codr-void/parking-counter/parking_counter/B_Layer.png

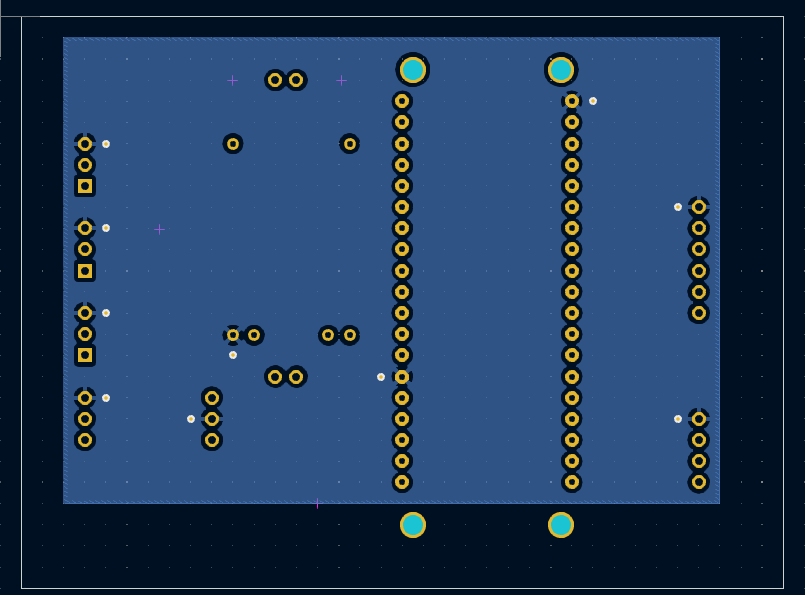
parking_counter/B_Layer.png
