codr-void/parking-counter/parking_counter/F_Layer.png

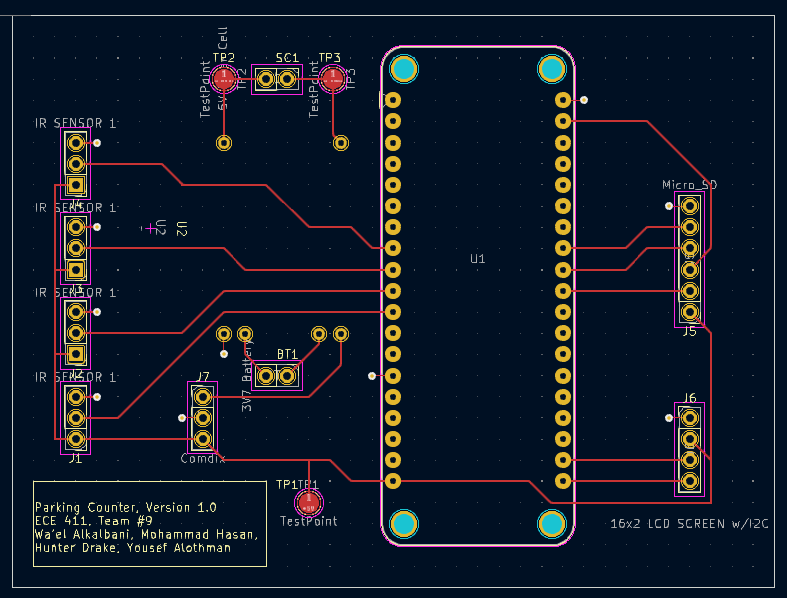
parking_counter/F_Layer.png
