codr-void/parking-counter/Team09_Bill_of_Materials.xlsx

Bill Of Materials for: Team09 - Wa'el Alkalbani, Mohammad Hasan, Hunter Drake, Yousef Alothman
Last modified: November 8th, 2023
PCB version: 1.0
BOM revision: 1.0 |  | P/NP | = Place/Not Place (components marked NP are not stuffed on the board)
Cnt | Part References | P/NP | Mfg | Mfg PN | Description | Dist | Dist Part Number | Cost Ea. | Cost Total
4 | J4,J3,J2,J1 | NP | HiLetGo | 3-01-1963 | IR SENSOR | amazon | 3-01-1963 | $0.88 | $3.52
1 | U2 | P | NanJing Top Power ASIC Corp | ‎TP4056 | BATTERY CHARGER | amazon | 0‎3-01-0205 | $0.78 | $0.78
1 | J7 | P | MicrOne | ME2108 | Step up voltage regualtor to control battery voltage to get 5v | amazon | CP323 | $0.80 | $0.80
1 | SC1 | NP | NA | NA | 5-6V solar panel | EPL | NA | $0.60 | $0.60
1 | J6 | NP | SunFounder | CN0295D | lcd screen with I2C interface | EPL | NA | $0.00 | $0.00
1 | U1 | P | HiLetGo | 211-181007 | esp32s microcontroller - with Wifi module | amazon | 03-01-1287 | $0.00 | $0.00
1 | J5 | P | ANMBEST | ‎ANMBEST_MD272 | SD card reader | amazon | ‎ANMBEST_MD272 | $1.80 | $1.80
1 | NA | P | NA | NA | SD card | EPL | NA | NA | NA | NOT ordered yet
1 | NA | NP | EPL | NA | 3D print of parking lot for the simulation | EPL | NA | NA | NA | NOT ordered yet
1 | NA | NP | EPL | NA | PCB | EPL | NA | NA | NA | NOT ordered yet
1 | BT1 | NP | AOLIKES | 2S1PMJ1 | 7.4V battery - 2600 mAh Lithium Ion | amazon | 2S1P Akku | $15.82 | $15.82
VERSION INFO
Rev | Date | Notes
1 | 2023-11-09 | Rough draft for the bill of materials - included items that we will need and it will be an expense for the next revision
