codr-void/parking-counter/full_parking_counter_bambu.3mf

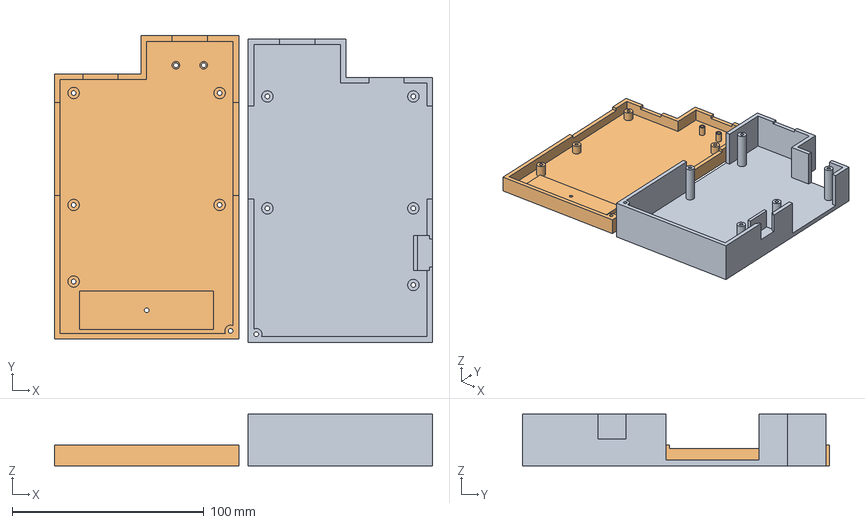
[picture p6: CAD file, 2023-12-07]
full_parking_counter_bambu.3mf
197.3 x 160.2 x 27.0 mm
Top
Bottom
