codr-void/parking-counter/parking_sim.3mf

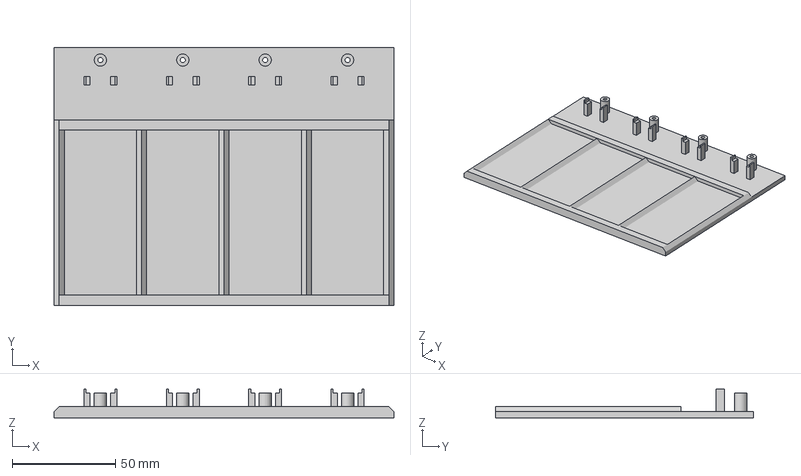
[picture p7: CAD file, 2023-12-07]
parking_sim.3mf
165.0 x 125.0 x 14.0 mm
