codr-void/parking-counter/solar_panel_housing.3mf

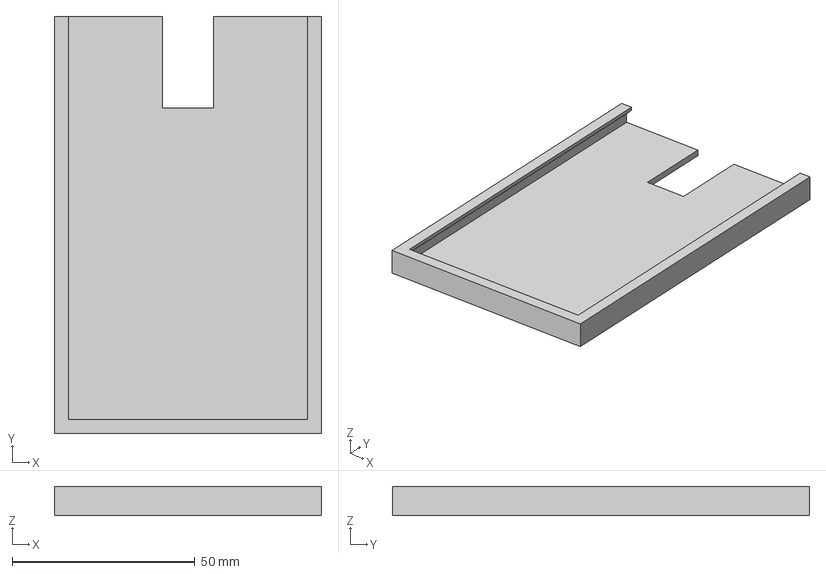
[picture p8: CAD file, 2023-12-07]
solar_panel_housing.3mf
73.0 x 114.0 x 8.00 mm
