codr-void/parking-counter/solar_panel_leg.3mf

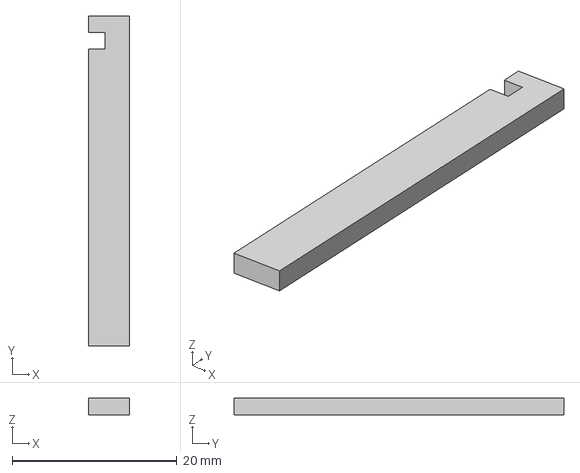
[picture p9: CAD file, 2023-12-07]
solar_panel_leg.3mf
5.00 x 40.0 x 2.00 mm
