codr-void/parking-counter/16x2_back.stl

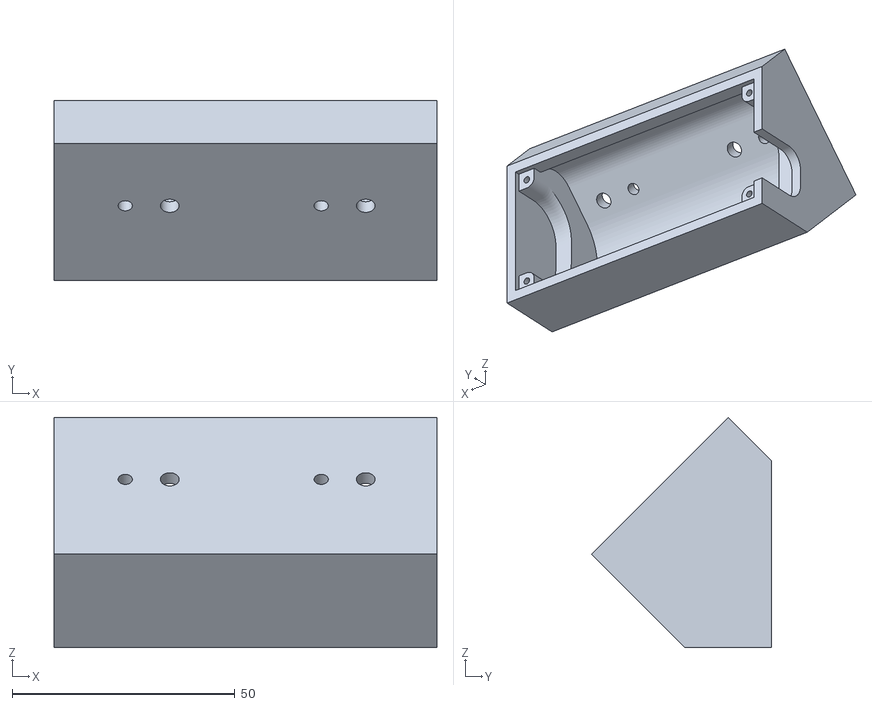
[picture p10: CAD file, 2023-12-07]
16x2_back.stl
86.0 x 40.4 x 51.7
