codr-void/parking-counter/16x2_front.stl

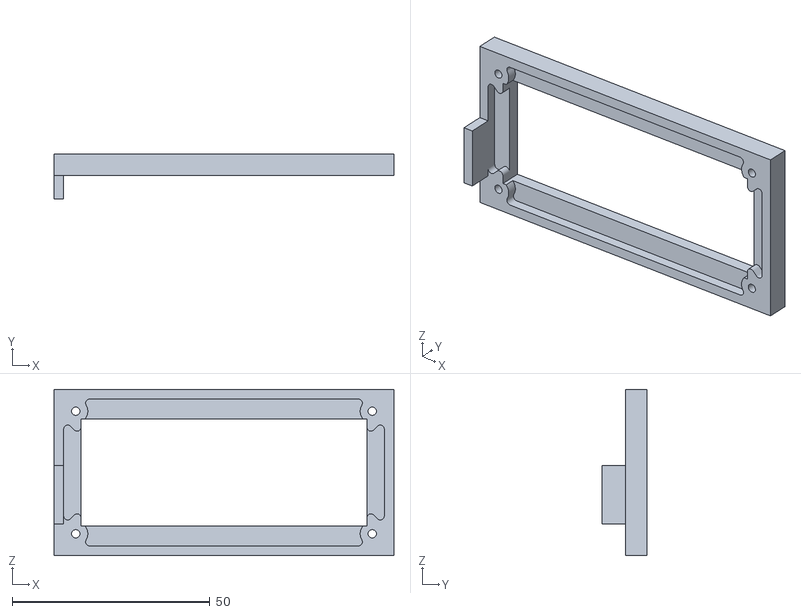
[picture p11: CAD file, 2023-12-07]
16x2_front.stl
86.0 x 11.5 x 42.0
