codr-void/parking-counter/parking_counter_preliminary_schematic.pdf

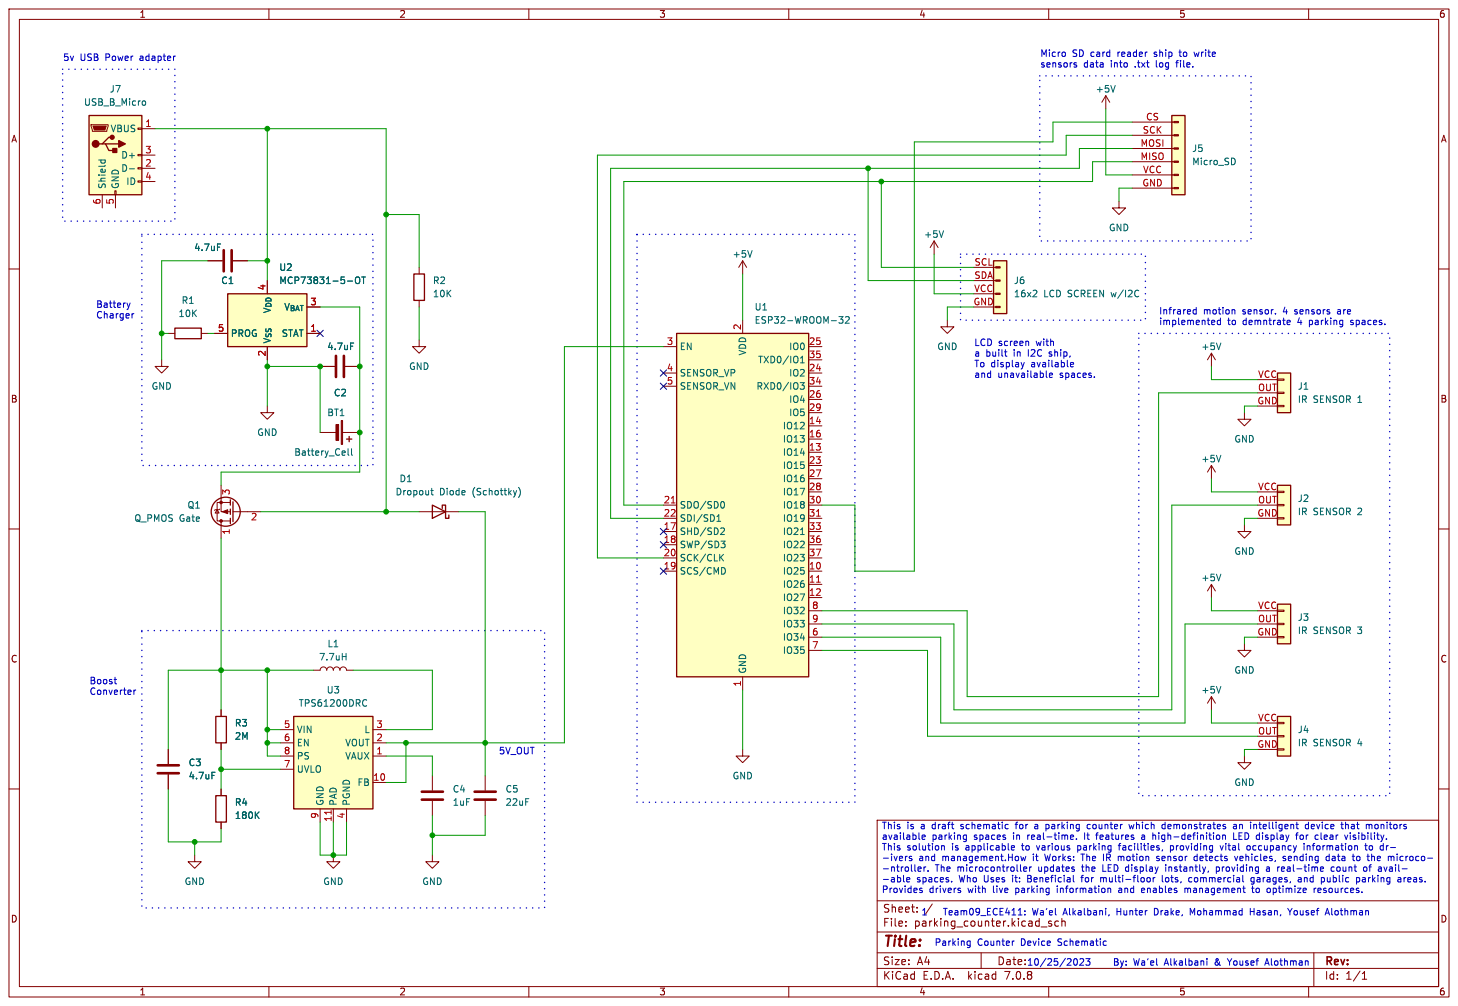
[picture p12: page 1]

Micro SD card reader ship to write

sensors data into .txt log file. 5v USB Power adapter

CS GND MISO MOSI SCK

VCC
IR SENSOR 2 GND GND

2 SCK/CLK 20 SDO/SD0 21 SDI/SD1 22

a built in I2C ship, To display available

3 Q1 Q_PMOS Gate D1 Dropout Diode (Schottky) L1

4 VIN 5 EN 6 UVLO 7 PS 8 GND

Id: 1/1 Title: File: parking_counter.kicad_sch Sheet: /
