codr-void/parking-counter/ECE 411 Functional Diagram Team #9.pdf

## Parking Counter Device: L1 Diagram

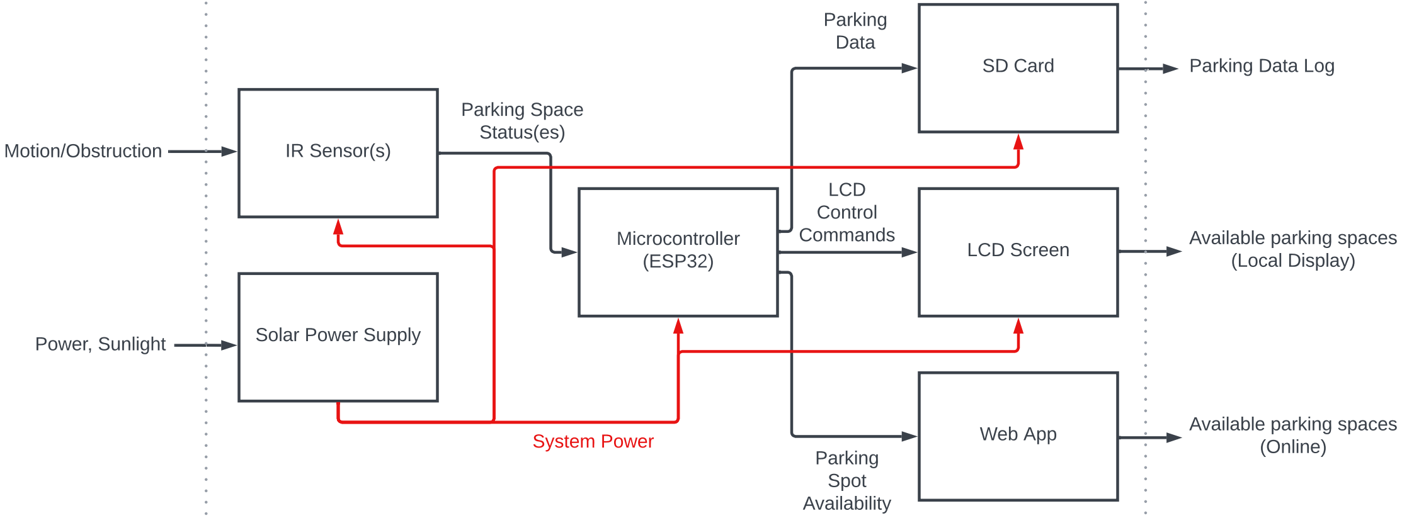
[picture p13: figure]
Microcontroller (ESP32); Solar Power Supply; IR Sensor(s); SD Card; LCD Screen; Web App; Power, Sunlight; Available parking spaces (Local Display); Parking Data Log; Available parking spaces (Online); Motion/Obstruction; System Power; Parking Space Status(es); Parking Data; LCD Control Commands; Parking Spot Availability
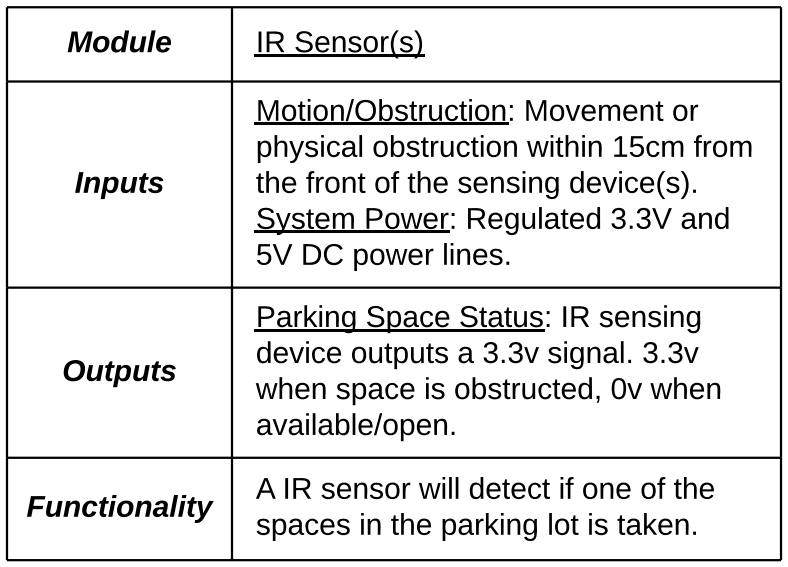
[picture p14: figure]
Module; IR Sensor(s); Inputs; Motion/Obstruction: Movement or physical obstruction within 15cm from the front of the sensing device(s). System Power: Regulated 3.3V and 5V DC power lines.; Outputs; Parking Space Status: IR sensing device outputs a 3.3v signal. 3.3v when space is obstructed, 0v when available/open.

Functionality | A IR sensor will detect if one of the spaces in the parking lot is taken.

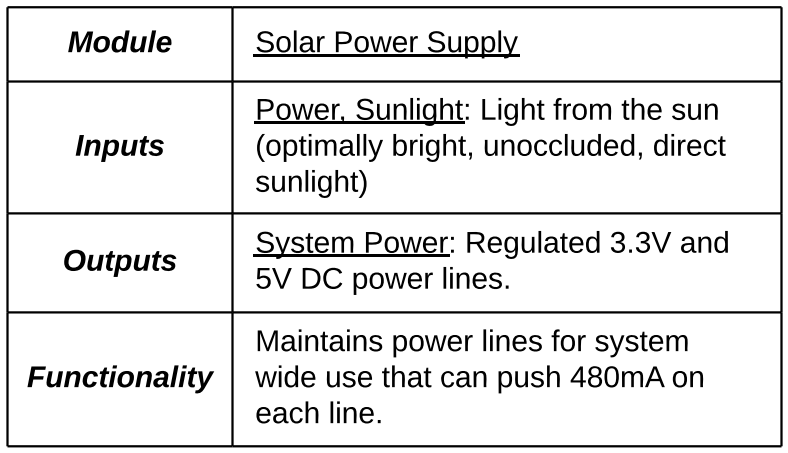
[picture p15: figure]
Module; Solar Power Supply; Inputs; Power, Sunlight: Light from the sun (optimally bright, unoccluded, direct sunlight); Outputs; System Power: Regulated 3.3V and; 5V DC power lines.

Functionality | Maintains power lines for system wide use that can push 480mA on each line.

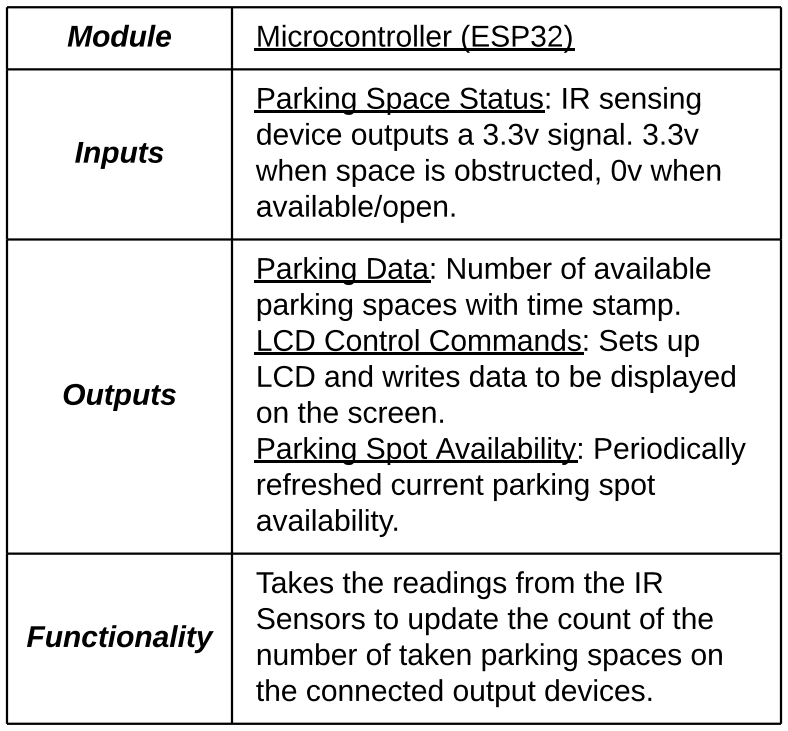
[picture p16: figure]
Module; Microcontroller (ESP32); Inputs; Parking Space Status: IR sensing device outputs a 3.3v signal. 3.3v when space is obstructed, 0v when available/open.; Outputs; Parking Data: Number of available parking spaces with time stamp. LCD Control Commands: Sets up LCD and writes data to be displayed on the screen. Parking Spot Availability: Periodically refreshed current parking spot availability.

Functionality | Takes the readings from the IR Sensors to update the count of the number of taken parking spaces on the connected output devices.
Module | SD Card
Inputs | Parking Data: Number of available parking spaces with time stamp.
Outputs | Parking Data Log: List of times with their corresponding measured number of parking spaces available.
Functionality | Logs parking data and time stamps.
Module | LCD Screen
Inputs | LCD Control Commands: Sets up LCD and writes data to be displayed on the screen.
Outputs | Available parking spaces (Local Display): The number of parking spaces not yet sensed as being taken displayed on hardware.
Functionality | Displays the number of parking spaces available on-site
Module | Web App
Inputs | Parking Spot Availability: Periodically refreshed current parking spot availability.
Outputs | Available parking spaces (Online): The number of parking spaces not yet sensed as being taken displayed on a Website.
Functionality | Displays the number of parking spaces available on a website

## Parking Counter Device: L0 Diagram

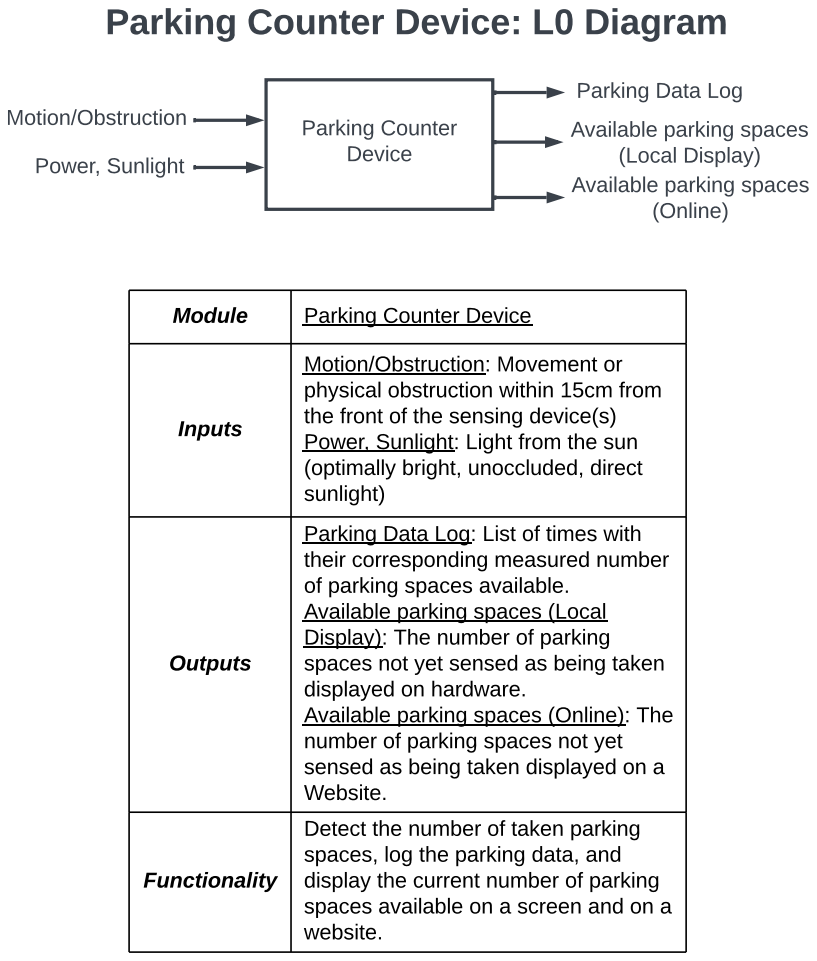
[picture p17: page 2]
Parking Counter Device; L0 and L1 Diagram; website.; Motion/Obstruction; Power, Sunlight; (Online)

Parking Data Log
Available parking spaces
(Local Display)

Module | Parking Counter Device
Inputs | Motion/Obstruction: Movement or physical obstruction within 15cm from the front of the sensing device(s) Power, Sunlight: Light from the sun (optimally bright, unoccluded, direct sunlight)

Outputs | Parking Data Log: List of times with their corresponding measured number Display): The number of parking spaces not yet sensed as being taken displayed on hardware. Available parking spaces (Online): The number of parking spaces not yet sensed as being taken displayed on a Website.

of parking spaces available.
Available parking spaces (Local

Functionality | Detect the number of taken parking spaces, log the parking data, and display the current number of parking Wa'el Alkalbani | November 8, 2023 spaces available on a screen and on a
