codr-void/parking-counter/ECE 411 Gantt Chart Team #9.pdf

## [ESP32 Controlled Parking Tracker]

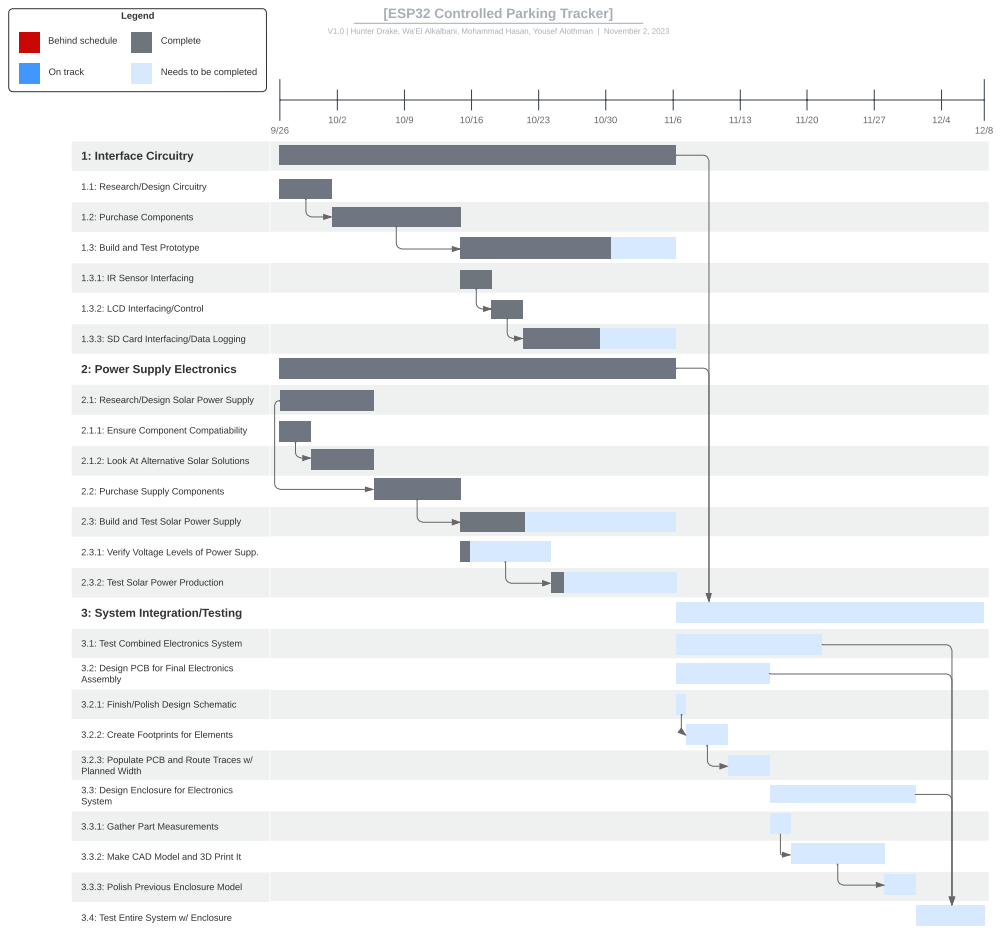
[picture p18: page 1]
Legend; Behind schedule; On track; Complete; 1.2: Purchase Components

V1.0 | Hunter Drake, Wa'El Alkalbani, Mohammad Hasan, Yousef Alothman | November 2, 2023

Needs to be completed

1: Interface Circuitry

1.1: Research/Design Circuitry

1.3: Build and Test Prototype

1.3.1: IR Sensor Interfacing

1.3.2: LCD Interfacing/Control

1.3.3: SD Card Interfacing/Data Logging

2: Power Supply Electronics

2.1: Research/Design Solar Power Supply

2.1.1: Ensure Component Compatiability

2.1.2: Look At Alternative Solar Solutions

2.2: Purchase Supply Components

2.3: Build and Test Solar Power Supply

2.3.1: Verify Voltage Levels of Power Supp.

2.3.2: Test Solar Power Production

3: System Integration/Testing

3.1: Test Combined Electronics System

3.2: Design PCB for Final Electronics Assembly

3.2.1: Finish/Polish Design Schematic

3.2.2: Create Footprints for Elements

3.2.3: Populate PCB and Route Traces w/ Planned Width

3.3: Design Enclosure for Electronics System

3.3.1: Gather Part Measurements

3.3.2: Make CAD Model and 3D Print It

3.3.3: Polish Previous Enclosure Model

3.4: Test Entire System w/ Enclosure
