codr-void/parking-counter/(commit log)

2023-10-19 product design specs pdf file will be inserted - might change in the future
2023-10-31 upload prototype video to github
2023-11-09 Bill of materials
    [Team09_Bill_of_Materials.xlsx]
2023-11-09 Add files via upload
    Schematic done
    [Ir_sensors.kicad_pcb, Ir_sensors.kicad_sch, parking_counter.kicad_pcb, parking_counter.kicad_sch]
